dorinadamian/P1_Dispozitive_electronice/Layout.JPG

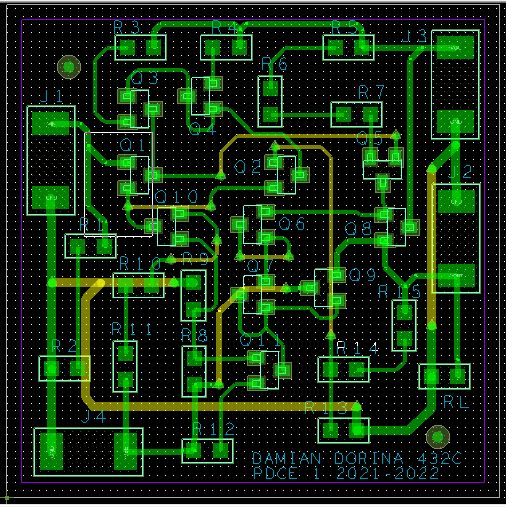
Layout.JPG
