dorinadamian/P1_Dispozitive_electronice/Schema electrica.JPG

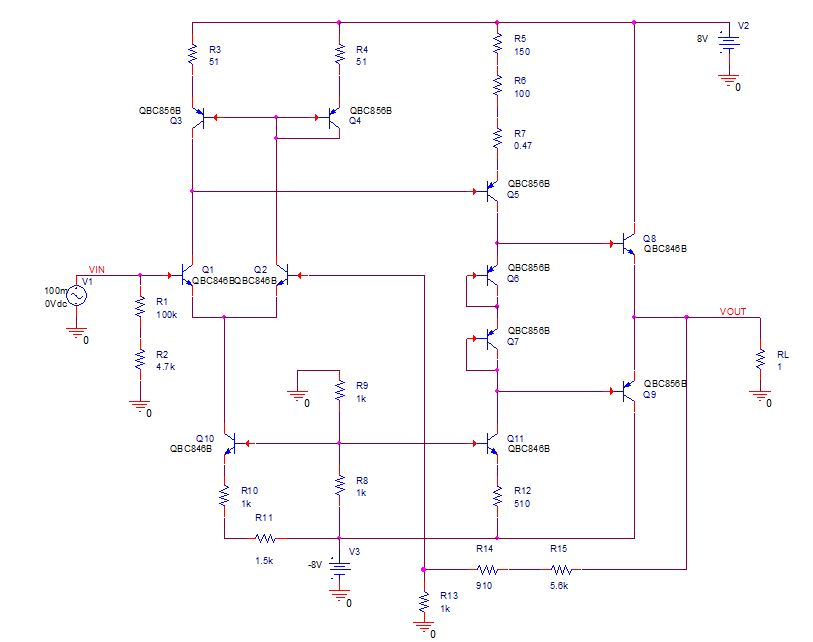
Schema electrica.JPG
