dorinadamian/P1_Dispozitive_electronice/schema_bloc.jpg

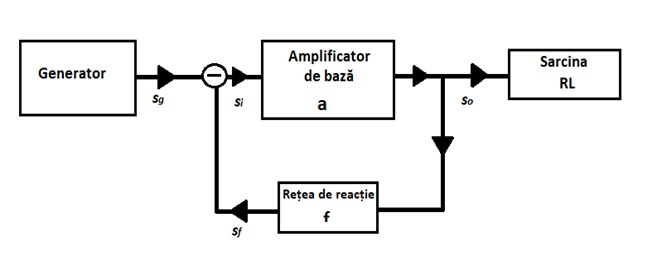
schema_bloc.jpg
