dorinadamian/P1_Dispozitive_electronice/Simulations/Amplificarea in bucla deschisa.JPG

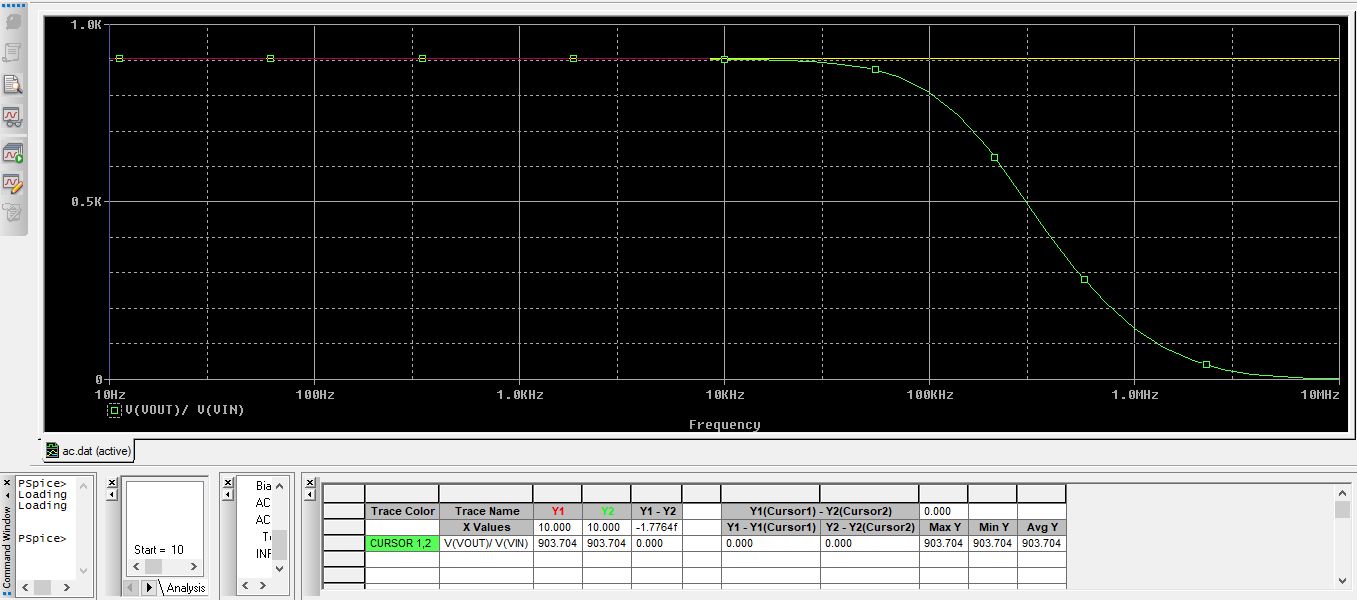
Simulations/Amplificarea in bucla deschisa.JPG
