dorinadamian/P1_Dispozitive_electronice/Simulations/Amplificarea in tensiune (bucla inchisa).JPG

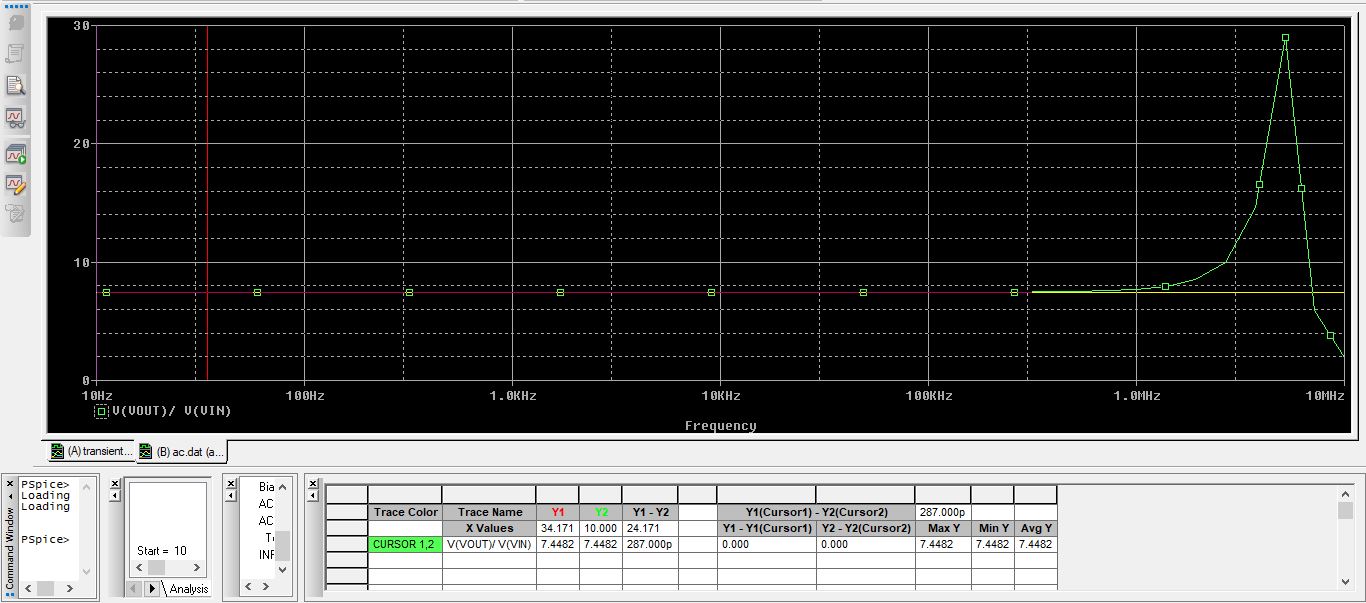
Simulations/Amplificarea in tensiune (bucla inchisa).JPG
