dorinadamian/P1_Dispozitive_electronice/(list of files, drawings)

Other design files:
Schematics/P1_amplificator/p1-amplificator.dsn
Schematics/P1_amplificator/P1-amplificator.opj
